shmatko1095/oshSchematic/BOM.ods

Sheet: Schematic
Source: | /media/user/SSD/projects/heatter/Schematic/Schematic.sch
Date: | чт, 14-жов-2021 22:14:58 +0300
Tool: | Eeschema 5.1.10-88a1d61d58~90~ubuntu20.04.1
Generator: | /usr/share/kicad/plugins/bom_csv_grouped_by_value_with_fp.py
Component Count: | 137
Ref | Qnty | Price x10 | Price |  |  | Value | Cmp name | Footprint | Description | Vendor
AE1, | 1 | 30 | 17.5 |  | FPC Antenna/GSM/2dbi/IPEX Connector | Antenna | Antenna | Connector_Wire:SolderWire-0.1sqmm_1x01_D0.4mm_OD1mm_Relief | Antenna
BT1, | 1 | 6.72 | 8 |  |  | CR2032-PBN2 | Battery_Cell | Battery:Battery_Panasonic_CR2032-VS1N_Vertical_CircularHoles | Single-cell battery
BZ1, | 1 | 36 | 50 |  |  | IE122305-7 | Buzzer | Buzzer_Beeper:Buzzer_12x9.5RM7.6 | Buzzer, polarized
C1, C8, C11, C12, C14, C16, C20, C23, | 8 | 0.2 |  | 40 |  | 0.1uF | C_Small | Capacitor_SMD:C_0805_2012Metric | Unpolarized capacitor, small symbol
C2, | 1 | 3.64 | 5 |  |  | 22uF | C_Small | Capacitor_SMD:C_1206_3216Metric | Unpolarized capacitor, small symbol
C3, C5, | 2 | 0.54 |  | 10 |  | 47pF | C_Small | Capacitor_SMD:C_0805_2012Metric | Unpolarized capacitor, small symbol
C4, C6, C10, | 3 | 0.61 |  | 10 |  | 10uF | C_Polarized | Capacitor_SMD:C_0805_2012Metric | Polarized capacitor
C7, C13, | 2 | 0.88 | 1.5 |  |  | 470uF | C_Polarized | Capacitor_THT:CP_Radial_D6.3mm_P2.50mm | Polarized capacitor
C15, | 1 | 4 | 5 |  |  | SMDCAP-470mkf - 10v | C_Polarized | Capacitor_SMD:CP_Elec_8x10 | Polarized capacitor
C17, C18, C19, C21, | 4 | 0.2 |  | 40 |  | 33pF | C_Small | Capacitor_SMD:C_0805_2012Metric | Unpolarized capacitor, small symbol
C24, C25, | 2 | 0 | 0 |  |  | NM | C_Small | Capacitor_SMD:C_0805_2012Metric | Unpolarized capacitor, small symbol
D1, D2, D3, D4, D5, D6, D7, D9, D10, | 7 | 0.1 | 1.5 |  |  | LED | LED | LED_SMD:LED_0805_2012Metric | Light emitting diode
D8, | 1 | 1 | 1.5 |  |  | BZV55B5V1 | BZV55B5V1 | Diode_SMD:D_MiniMELF | 5.1V, 500mW, 2%, Zener diode, MiniMELF
D11, D14, D15, D18, D20, D21, D22, D23, D24, D25, | 10 | 0.3 | 2.5 |  |  | ESD5Z3.3T1G | DZ2S030X0L | Diode_SMD:D_SOD-523 | 150mW Silicon Planar Zener Diode, 3.0V, SOD-523
D12, D16, D17, D19, | 4 | 2.6 | 7.5 |  |  | PESD5V0L4UG | PESD5V0L4UG | Package_TO_SOT_SMD:SOT-353_SC-70-5 | Low capacitance unidirectional quadruple ESD protection diode array, 5.0V, Common Anode, SOT-353
D13, | 1 | 2.6 | 7.5 |  |  | PESD3V3L4UG | PESD3V3L4UG | Package_TO_SOT_SMD:SOT-353_SC-70-5 | Low capacitance unidirectional quadruple ESD protection diode array, 3.3V, Common Anode, SOT-353
F1, | 1 | 0.6 | 1.5 |  | FUSE 0.5A 250V 3X10 | 3,6x10 0.5A | Fuse | Fuse:Fuse_BelFuse_0ZRE0033FF_L11.4mm_W3.8mm | Fuse
J1, | 1 | 1.6 | 2.5 |  | NCDW-02 | CS | Conn_01x02 | Connector_PinSocket_2.54mm:PinSocket_1x02_P2.54mm_Vertical | Generic connector, single row, 01x02, script generated (kicad-library-utils/schlib/autogen/connector/)
J2, | 1 | 0 | 0 |  | PLS-40-BLACK | CC2538_USB | Conn_01x03 | Connector_PinSocket_2.54mm:PinSocket_1x03_P2.54mm_Vertical | Generic connector, single row, 01x03, script generated (kicad-library-utils/schlib/autogen/connector/)
J3, | 1 | 0 | 0 |  | ZL202-20G | CC2538_JTAG | Conn_02x05_Odd_Even | Connector_PinHeader_2.54mm:PinHeader_2x05_P2.54mm_Vertical | Generic connector, double row, 02x05, odd/even pin numbering scheme (row 1 odd numbers, row 2 even numbers), script generated (kicad-library-utils/schlib/autogen/connector/)
J4, J5, J6, J7, | 4 | 2.4 | 3.5 |  | NCDW-03 | DS18B20 | Conn_01x03 | Connector_PinSocket_2.54mm:PinSocket_1x03_P2.54mm_Vertical | Generic connector, single row, 01x03, script generated (kicad-library-utils/schlib/autogen/connector/)
J8, | 1 | 3 | 4.5 |  | BH-08 | Heater Board | Conn_02x04_Odd_Even | Connector_PinSocket_2.54mm:PinSocket_2x04_P2.54mm_Vertical | Generic connector, double row, 02x04, odd/even pin numbering scheme (row 1 odd numbers, row 2 even numbers), script generated (kicad-library-utils/schlib/autogen/connector/)
J9, | 1 | 2.4 | 3.5 |  | NCDW-03 | TCBBA00 | Conn_01x03 | Connector_PinSocket_2.54mm:PinSocket_1x03_P2.54mm_Vertical | Generic connector, single row, 01x03, script generated (kicad-library-utils/schlib/autogen/connector/)
J10, | 1 | 13.62 | 19 |  | NANOSIM-HINGE-1.5H | SIM_Card | SIM_Card | Connector_Card:NANOSIM_HINGE_1.5H | SIM Card
J11, | 1 | 1 | 2 |  |  | ESP_UART | Conn_02x03_Odd_Even | Connector_PinHeader_2.54mm:PinHeader_2x03_P2.54mm_Vertical | Generic connector, double row, 02x03, odd/even pin numbering scheme (row 1 odd numbers, row 2 even numbers), script generated (kicad-library-utils/schlib/autogen/connector/)
J12, | 1 | 1 | 9 |  | ZL202-20G | ESP_JTAG | Conn_02x05_Odd_Even | Connector_PinHeader_2.54mm:PinHeader_2x05_P2.54mm_Vertical | Generic connector, double row, 02x05, odd/even pin numbering scheme (row 1 odd numbers, row 2 even numbers), script generated (kicad-library-utils/schlib/autogen/connector/)
J13, | 1 | 2.5 | 3 |  | DG126-5.0-02P-14-00AH | 220V | Conn_01x02 | Connector_Phoenix_MSTB:PhoenixContact_MSTBA_2,5_2-G_1x02_P5.00mm_Horizontal | Generic connector, single row, 01x02, script generated (kicad-library-utils/schlib/autogen/connector/)
J16, | 1 | 11.34 | 13.5 |  | DS1065-03-2X6S8BV ZL322-2X6P | Conn_TFT | Conn_02x06_Odd_Even | Connector_PinHeader_1.27mm:PinHeader_2x06_P1.27mm_Vertical | Generic connector, double row, 02x06, odd/even pin numbering scheme (row 1 odd numbers, row 2 even numbers), script generated (kicad-library-utils/schlib/autogen/connector/)
PS1, | 1 | 258 | 258 |  |  | IRM-20-5 | IRM-20-5 | Converter_ACDC:Converter_ACDC_MeanWell_IRM-20-xx_THT | 5V, 4A, 20W, Isolated, AC-DC, 219A(IRM20)
Q1, Q3, Q4, Q5, | 4 | 0.3 |  | 10 |  | BC847 | BC847 | Package_TO_SOT_SMD:SOT-23 | 0.1A Ic, 45V Vce, NPN Transistor, SOT-23
R1, R2, R4, R5, R10, R11, R15, R16, R21, R23, R24, R25, R26, R27, | 14 | 0.06 |  | 12 |  | 10k | R | Resistor_SMD:R_0805_2012Metric | Resistor
R3, | 1 | 0.09 |  | 17 |  | 100 1/8W | R | Resistor_SMD:R_1206_3216Metric | Resistor
R6, R7, R8, R9, R17, R18, R19, R20, R36, R51, R52, R53, R54, R55, R56, | 15 | 0.06 |  | 12 |  | 1k | R | Resistor_SMD:R_0805_2012Metric | Resistor
R12, R13, | 2 | 0.38 |  | 10 |  | 33 | R | Resistor_SMD:R_0805_2012Metric | Resistor
R14, | 1 | 0.06 |  | 12 |  | 1k5 | R | Resistor_SMD:R_0805_2012Metric | Resistor
R22, R39, R40, R43, | 4 | 0.06 |  | 12 |  | 47k | R | Resistor_SMD:R_0805_2012Metric | Resistor
R33, | 1 | 0.06 |  | 12 |  | 124k | R | Resistor_SMD:R_0805_2012Metric | Resistor
R34, | 1 | 0.06 |  | 12 |  | 56k | R | Resistor_SMD:R_0805_2012Metric | Resistor
R37, R38, R42, | 3 | 0.06 |  | 12 |  | 4k7 | R | Resistor_SMD:R_0805_2012Metric | Resistor
R41, R44, | 2 | 0.06 |  | 12 |  | 300R | R | Resistor_SMD:R_0805_2012Metric | Resistor
R45, R46, R47, | 3 | 0.06 |  | 12 |  | 22R | R | Resistor_SMD:R_0805_2012Metric | Resistor
R48, R49, R50, | 3 | 0.06 |  | 12 |  | 5k6 | R | Resistor_SMD:R_0805_2012Metric | Resistor
R57, | 1 | 0.06 |  | 12 |  | 0R | R | Resistor_SMD:R_0805_2012Metric | Resistor
RV1, | 1 | 2.7 | 3 |  |  | 10D561K | Varistor | Varistor:RV_Disc_D12mm_W3.9mm_P7.5mm | Voltage dependent resistor
U1, | 1 | 62.1 |  |  |  | ESP32-S2-WROVER-I | ESP32-S2-WROVER-I | RF_Module:ESP32-S2-WROVER | RF Module, ESP32-D0WDQ6 SoC, Wi-Fi 802.11b/g/n, 32-bit, 2.7-3.6V, onboard antenna, SMD
U2, | 1 | 160 | 251 |  |  | CC2538_CC2592 | CC2538_CC2592 | RF_Module:CC2538_CC2592 | Chinese CC2538_CC2592 zigbee module SZ12 V2 BTTCOM
U3, | 1 | 27 | 111.5 |  |  | DS3231M | DS3231M | Package_SO:SOIC-16W_7.5x10.3mm_P1.27mm | Extremely Accurate I2C-Integrated RTC/TCXO/Crystal SOIC-16
U5, | 1 | 12 | 43 |  |  | LD1086DT33TR | LD1086DT33TR | Package_TO_SOT_SMD:TO-252-2 | Positive, 1.5A 30V, Linear Regulator, Fixed Output 3.3V, TO-252
U6, | 1 | 15 | 106 |  |  | MIC29302AWU | MIC29302WU | Package_TO_SOT_SMD:TO-263-5_TabPin3 | 3A low dropout linear regulator, adjustable output, TO-263
U7, | 1 |  |  |  |  | M66 | M66 | RF_GSM:Quectel_M66
 |  | 667.08 | 1211

Sheet: Sheet2
Source: | /media/user/SSD/projects/heatter/Schematic/LCD_board/LCD_board.sch
Date: | чт, 14-жов-2021 22:16:45 +0300
Tool: | Eeschema 5.1.10-88a1d61d58~90~ubuntu20.04.1
Generator: | /usr/share/kicad/plugins/bom_csv_grouped_by_value_with_fp.py
Component Count: | 10
Ref | Qnty | Value | Cmp name | Footprint | Description | Vendor
C1, | 1 | 10uF | C | Capacitor_SMD:C_1210_3225Metric | Unpolarized capacitor
C2, | 1 | 0.1uF | C | Capacitor_SMD:C_0805_2012Metric | Unpolarized capacitor
J1, | 1 | Conn_02x06 | Conn_02x06_Odd_Even | Connector_PinHeader_1.27mm:PinHeader_2x06_P1.27mm_Vertical_SMD | Generic connector, double row, 02x06, odd/even pin numbering scheme (row 1 odd numbers, row 2 even numbers), script generated (kicad-library-utils/schlib/autogen/connector/)
Q1, | 1 | BC847 | BC847 | Package_TO_SOT_SMD:SOT-23 | 0.1A Ic, 45V Vce, NPN Transistor, SOT-23
R1, | 1 | 1k | R | Resistor_SMD:R_0805_2012Metric | Resistor
R2, | 1 | 47k | R | Resistor_SMD:R_0805_2012Metric | Resistor
R3, R4, | 2 | 10k | R | Resistor_SMD:R_0805_2012Metric | Resistor
R5, | 1 | 300R | R | Resistor_SMD:R_0805_2012Metric | Resistor
U1, | 1 | TT130RGC17B | TT130RGC17B | Connector_FFC-FPC:TE_1-1734839-8_1x18-1MP_P0.5mm_Horizontal | TT130RGC17B is a color round active matrix and touch screen with capacitance thin film transistor(TFT)liquid crystal display(LCD)that uses amorphous silicon TFT as a switching device. This TFT LCD has a 1.3inch diagonally measured active display area with (240 horizontal by 240 vertical pixels)resolution.
