shmatko1095/oshSchematic/Schematic.kicad_pcb

## KiCad design Schematic.kicad_pcb (2021-10-18)

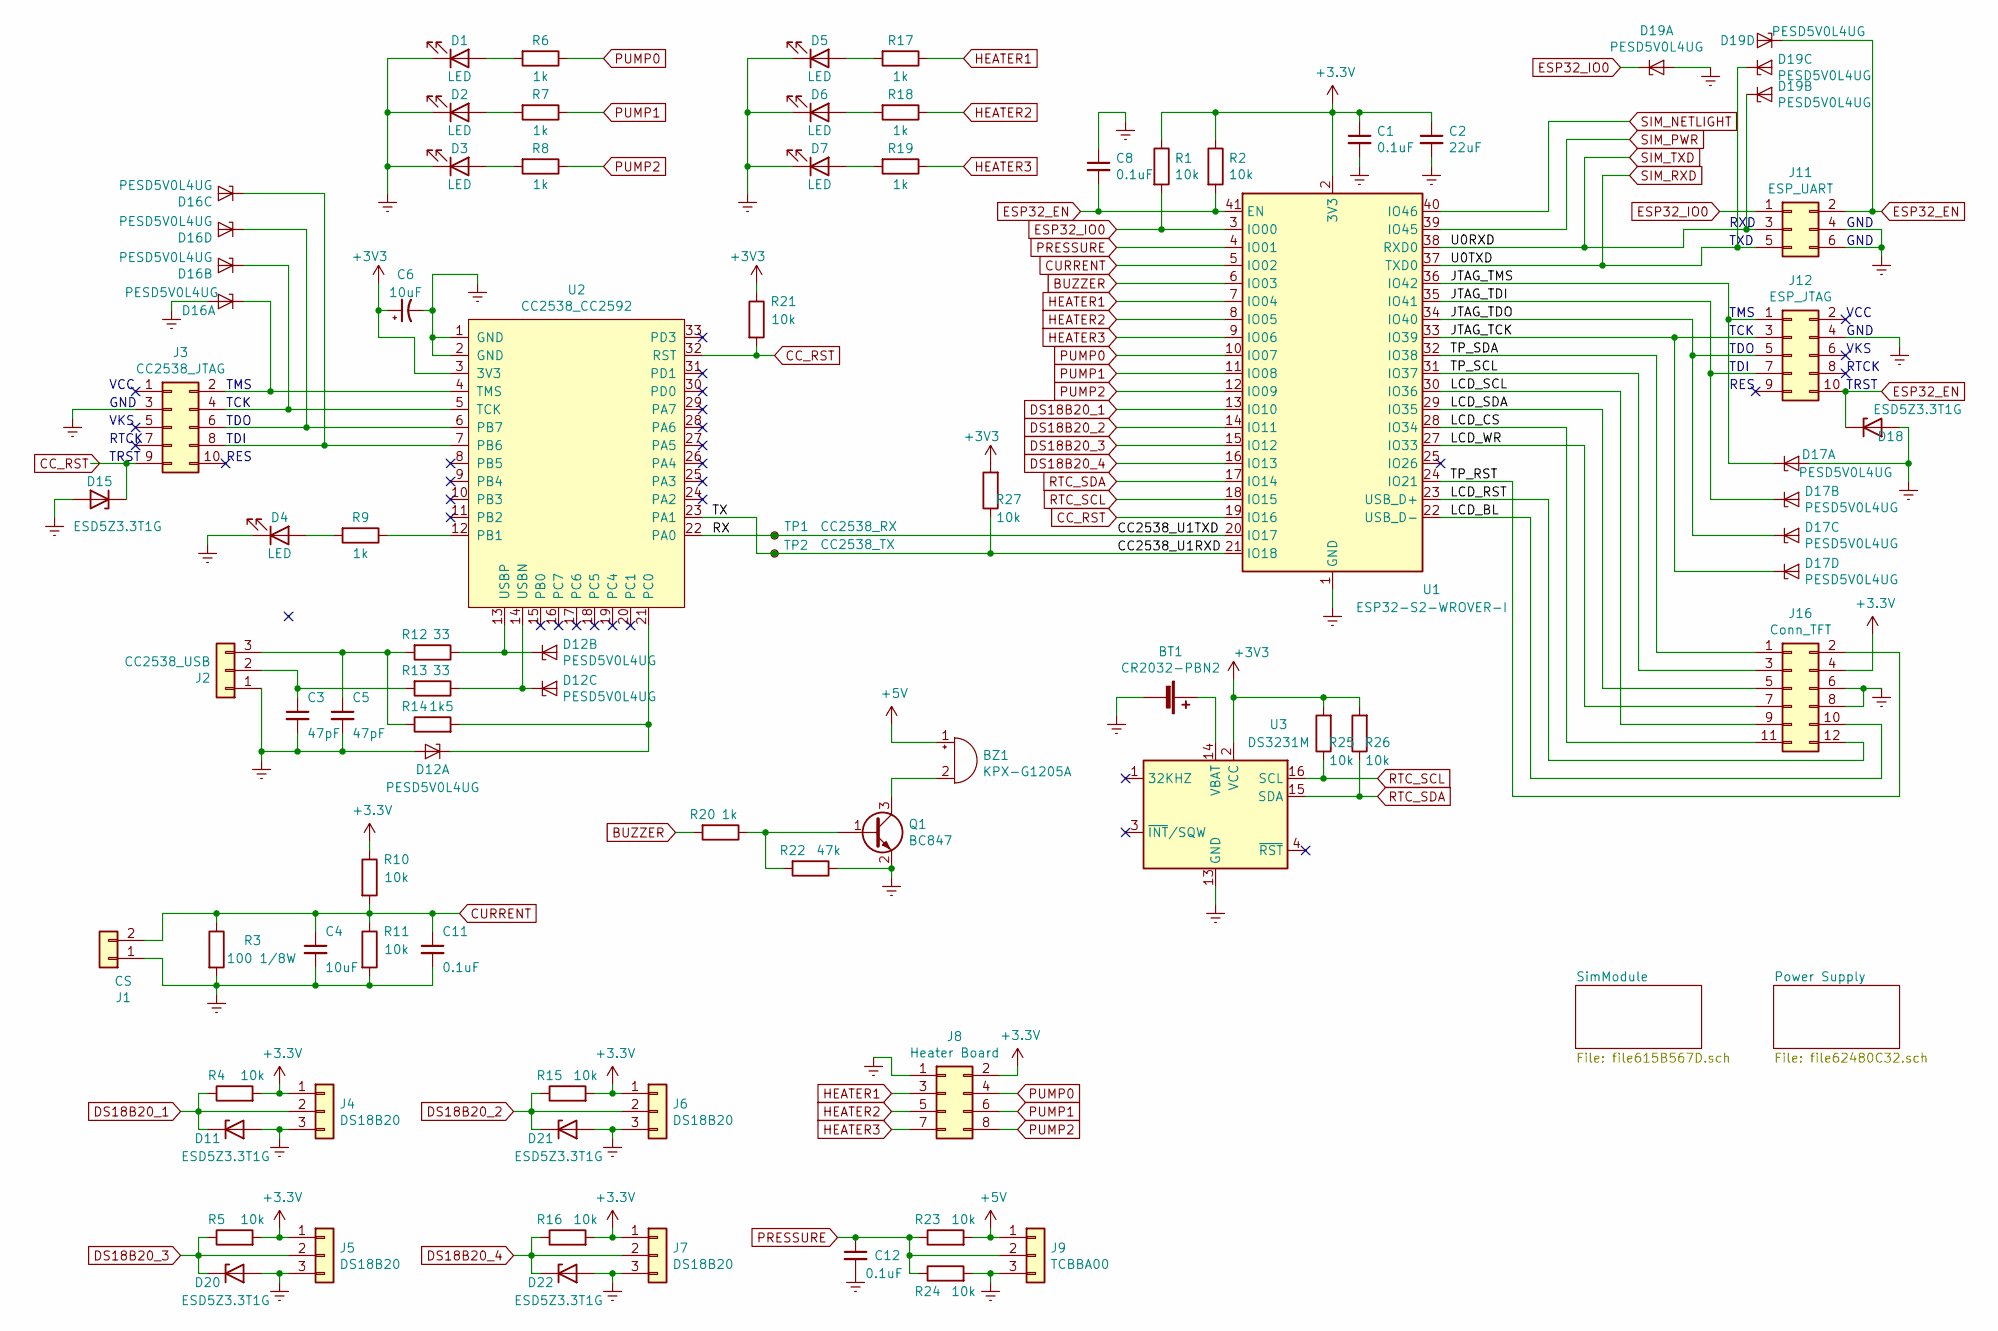
[picture p1: schematic Schematic.sch]

Parts:
BT1: CR2032-PBN2; Battery_Panasonic_CR2032-VS1N_Vertical_CircularHoles
BZ1: KPX-G1205A; Buzzer_12x9.5RM7.6
C1, C8, C11, C12: 0.1uF; C_0805_2012Metric
C2: 22uF; C_1206_3216Metric
C3, C5: 47pF; C_0805_2012Metric
C4, C6: 10uF; C_0805_2012Metric
D1, D2, D3, D4, D5, D6, D7: LED; LED_0805_2012Metric
D11, D15, D18, D20, D21, D22: ESD5Z3.3T1G; D_SOD-523
D12, D16, D17, D19: PESD5V0L4UG; SOT-353_SC-70-5
J1: CS; PinSocket_1x02_P2.54mm_Vertical
J2: CC2538_USB; PinSocket_1x03_P2.54mm_Vertical
J3: CC2538_JTAG; PinHeader_2x05_P2.54mm_Vertical
J4, J5, J6, J7: DS18B20; PinSocket_1x03_P2.54mm_Vertical
J8: Heater Board; PinSocket_2x04_P2.54mm_Vertical
J9: TCBBA00; PinSocket_1x03_P2.54mm_Vertical
J11: ESP_UART; PinHeader_2x03_P2.54mm_Vertical
J12: ESP_JTAG; PinHeader_2x05_P2.54mm_Vertical
J16: Conn_TFT; PinHeader_2x06_P1.27mm_Vertical
Q1: BC847; SOT-23
R1, R2, R4, R5, R10, R11, R15, R16, R21, R23, R24, R25, R26, R27: 10k; R_0805_2012Metric
R3: 100 1/8W; R_1206_3216Metric
R6, R7, R8, R9, R17, R18, R19, R20: 1k; R_0805_2012Metric
R12, R13: 33; R_0805_2012Metric
R14: 1k5; R_0805_2012Metric
R22: 47k; R_0805_2012Metric
TP1: CC2538_RX; TestPoint_Pad_D1.5mm
TP2: CC2538_TX; TestPoint_Pad_D1.5mm
U1: ESP32-S2-WROVER-I; ESP32-S2-WROVER
U2: CC2538_CC2592
U3: DS3231M; SOIC-16W_7.5x10.3mm_P1.27mm

Connections:
+5V: BZ1.1 (-), J9.1, R23.2; also elsewhere on the board
/CC2538_U1RXD: R27.1, TP2.1, U1.21 (IO18), U2.23 (PA1)
/CC2538_U1TXD: TP1.1, U1.20 (IO17), U2.22 (PA0)
/JTAG_TCK: D17.5 (K4), J12.3, U1.33 (IO39)
/JTAG_TDI: D17.3 (K2), J12.7, U1.35 (IO41)
/JTAG_TDO: D17.4 (K3), J12.5, U1.34 (IO40)
/JTAG_TMS: D17.1 (K1), J12.1, U1.36 (IO42)
/LCD_BL: J16.10, U1.22 (USB_D-)
/LCD_CS: J16.11, U1.28 (IO34)
/LCD_RST: J16.12, U1.23 (USB_D+)
/LCD_SCL: J16.9, U1.30 (IO36)
/LCD_SDA: J16.5, U1.29 (IO35)
/LCD_WR: J16.7, U1.27 (IO33)
/TP_RST: J16.2, U1.24 (IO21)
/TP_SCL: J16.3, U1.31 (IO37)
/TP_SDA: J16.1, U1.32 (IO38)
BUZZER: R20.2, U1.6 (IO03)
CC_RST: D15.1 (K), J3.9, R21.2, U1.19 (IO16), U2.32 (RST)
CURRENT: C4.1, C11.1, J1.2, R3.1, R10.2, R11.1, U1.5 (IO02)
DS18B20_1: D11.1 (K), J4.2, R4.1, U1.13 (IO10)
DS18B20_2: D21.1 (K), J6.2, R15.1, U1.14 (IO11)
DS18B20_3: D20.1 (K), J5.2, R5.1, U1.15 (IO12)
DS18B20_4: D22.1 (K), J7.2, R16.1, U1.16 (IO13)
ESP32_EN: C8.2, D18.1 (K), D19.5 (K4), J11.2, J12.10, R2.2, U1.41 (EN)
ESP32_IO0: D19.1 (K1), J11.1, R1.2, U1.3 (IO00)
Earth: BT1.2 (-), C1.2, C2.2, C3.2, C4.2, C5.2, C6.2, C8.1, C11.2, C12.2, D1.1 (K), D2.1 (K), D3.1 (K), D4.1 (K), D5.1 (K), D6.1 (K), D7.1 (K), D11.2 (A), D12.2 (A), D15.2 (A), D16.2 (A), D17.2 (A), D18.2 (A), D19.2 (A), D20.2 (A), D21.2 (A), D22.2 (A), J1.1, J2.1, J3.3, J4.3, J5.3, J6.3, J7.3, J8.1, J9.3, J11.4, J11.6, J12.4, J16.6, J16.8, Q1.2 (E), R3.2, R11.2, R22.1, R24.2, U1.1 (GND), U1.26 (GND), U1.42 (GND), U1.43 (GND), U2.1 (GND), U2.2 (GND), U3.5 (GND), U3.6 (GND), U3.7 (GND), U3.8 (GND), U3.9 (GND), U3.10 (GND), U3.11 (GND), U3.12 (GND), U3.13 (GND); also elsewhere on the board
HEATER1: J8.3, R17.1, U1.7 (IO04)
HEATER2: J8.5, R18.1, U1.8 (IO05)
HEATER3: J8.7, R19.1, U1.9 (IO06)
unnamed: BT1.1 (+), U3.14 (VBAT)
unnamed: BZ1.2 (+), Q1.3 (C)
unnamed: C3.1, J2.2, R13.2
unnamed: C5.1, J2.3, R12.2, R14.1
unnamed: D1.2 (A), R6.2
unnamed: D2.2 (A), R7.2
unnamed: D3.2 (A), R8.2
unnamed: D4.2 (A), R9.2
unnamed: D5.2 (A), R17.2
unnamed: D6.2 (A), R18.2
unnamed: D7.2 (A), R19.2
unnamed: D12.1 (K1), R14.2, U2.21 (PC0)
unnamed: D12.3 (K2), R12.1, U2.13 (USBP)
unnamed: D12.4 (K3), R13.1, U2.14 (USBN)
unnamed: D16.1 (K1), J3.2, U2.4 (TMS)
unnamed: D16.3 (K2), J3.4, U2.5 (TCK)
unnamed: D16.4 (K3), J3.8, U2.7 (PB6)
unnamed: D16.5 (K4), J3.6, U2.6 (PB7)
unnamed: Q1.1 (B), R20.1, R22.2
unnamed: R9.1, U2.12 (PB1)
PRESSURE: C12.1, J9.2, R23.1, R24.1, U1.4 (IO01)
PUMP0: J8.4, R6.1, U1.10 (IO07)
PUMP1: J8.6, R7.1, U1.11 (IO08)
PUMP2: J8.8, R8.1, U1.12 (IO09)
RTC_SCL: R25.1, U1.18 (IO15), U3.16 (SCL)
RTC_SDA: R26.1, U1.17 (IO14), U3.15 (SDA)
SIM_NETLIGHT: U1.40 (IO46); also elsewhere on the board
SIM_PWR: U1.39 (IO45); also elsewhere on the board
SIM_RXD: D19.4 (K3), J11.5, U1.37 (TXD0); also elsewhere on the board
SIM_TXD: D19.3 (K2), J11.3, U1.38 (RXD0); also elsewhere on the board

Notes on the sheet:
VCC
TRST
RTCK
GND
VKS
TMS
TCK
TDO
TDI
RES
RXD
TXD

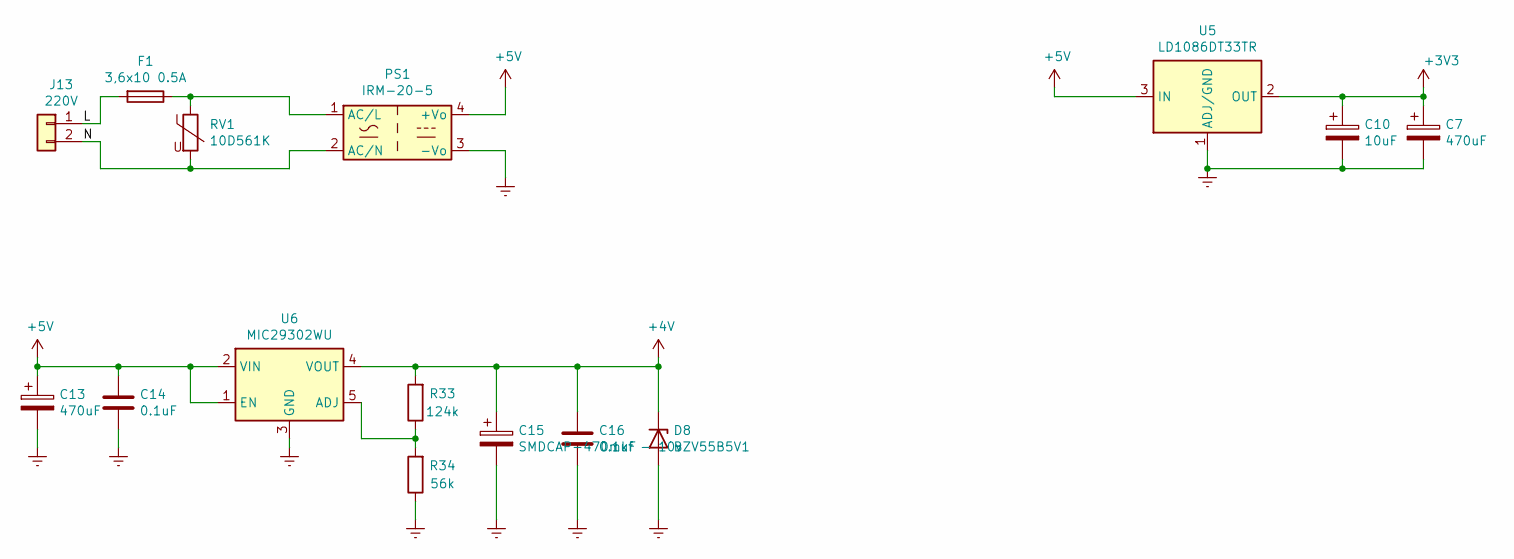
[picture p2: schematic file62480C32.sch]

Parts:
C7, C13: 470uF; CP_Radial_D6.3mm_P2.50mm
C10: 10uF; C_0805_2012Metric
C14, C16: 0.1uF; C_0805_2012Metric
C15: SMDCAP-470mkf - 10v; CP_Elec_8x10
D8: BZV55B5V1; D_MiniMELF
F1: 3,6x10 0.5A; Fuse_BelFuse_0ZRE0033FF_L11.4mm_W3.8mm
J13: 220V; PhoenixContact_MSTBA_2,5_2-G_1x02_P5.00mm_Horizontal
PS1: IRM-20-5; Converter_ACDC_MeanWell_IRM-20-xx_THT
R33: 124k; R_0805_2012Metric
R34: 56k; R_0805_2012Metric
RV1: 10D561K; RV_Disc_D12mm_W3.9mm_P7.5mm
U5: LD1086DT33TR; TO-252-2
U6: MIC29302WU; TO-263-5_TabPin3

Connections:
+4V: C15.1, C16.1, D8.1 (K), R33.2, U6.4 (VOUT); also elsewhere on the board
+5V: C13.1, C14.1, PS1.4 (+Vo), U5.3 (IN), U6.1 (EN), U6.2 (VIN); also elsewhere on the board
/Power Supply/L: F1.2, J13.1
/Power Supply/N: J13.2, PS1.2 (AC/N), RV1.2
Earth: C7.2, C10.2, C13.2, C14.2, C15.2, C16.2, D8.2 (A), PS1.3 (-Vo), R34.1, U5.1 (ADJ/GND), U6.3 (GND); also elsewhere on the board
unnamed: F1.1, PS1.1 (AC/L), RV1.1
unnamed: R33.1, R34.2, U6.5 (ADJ)

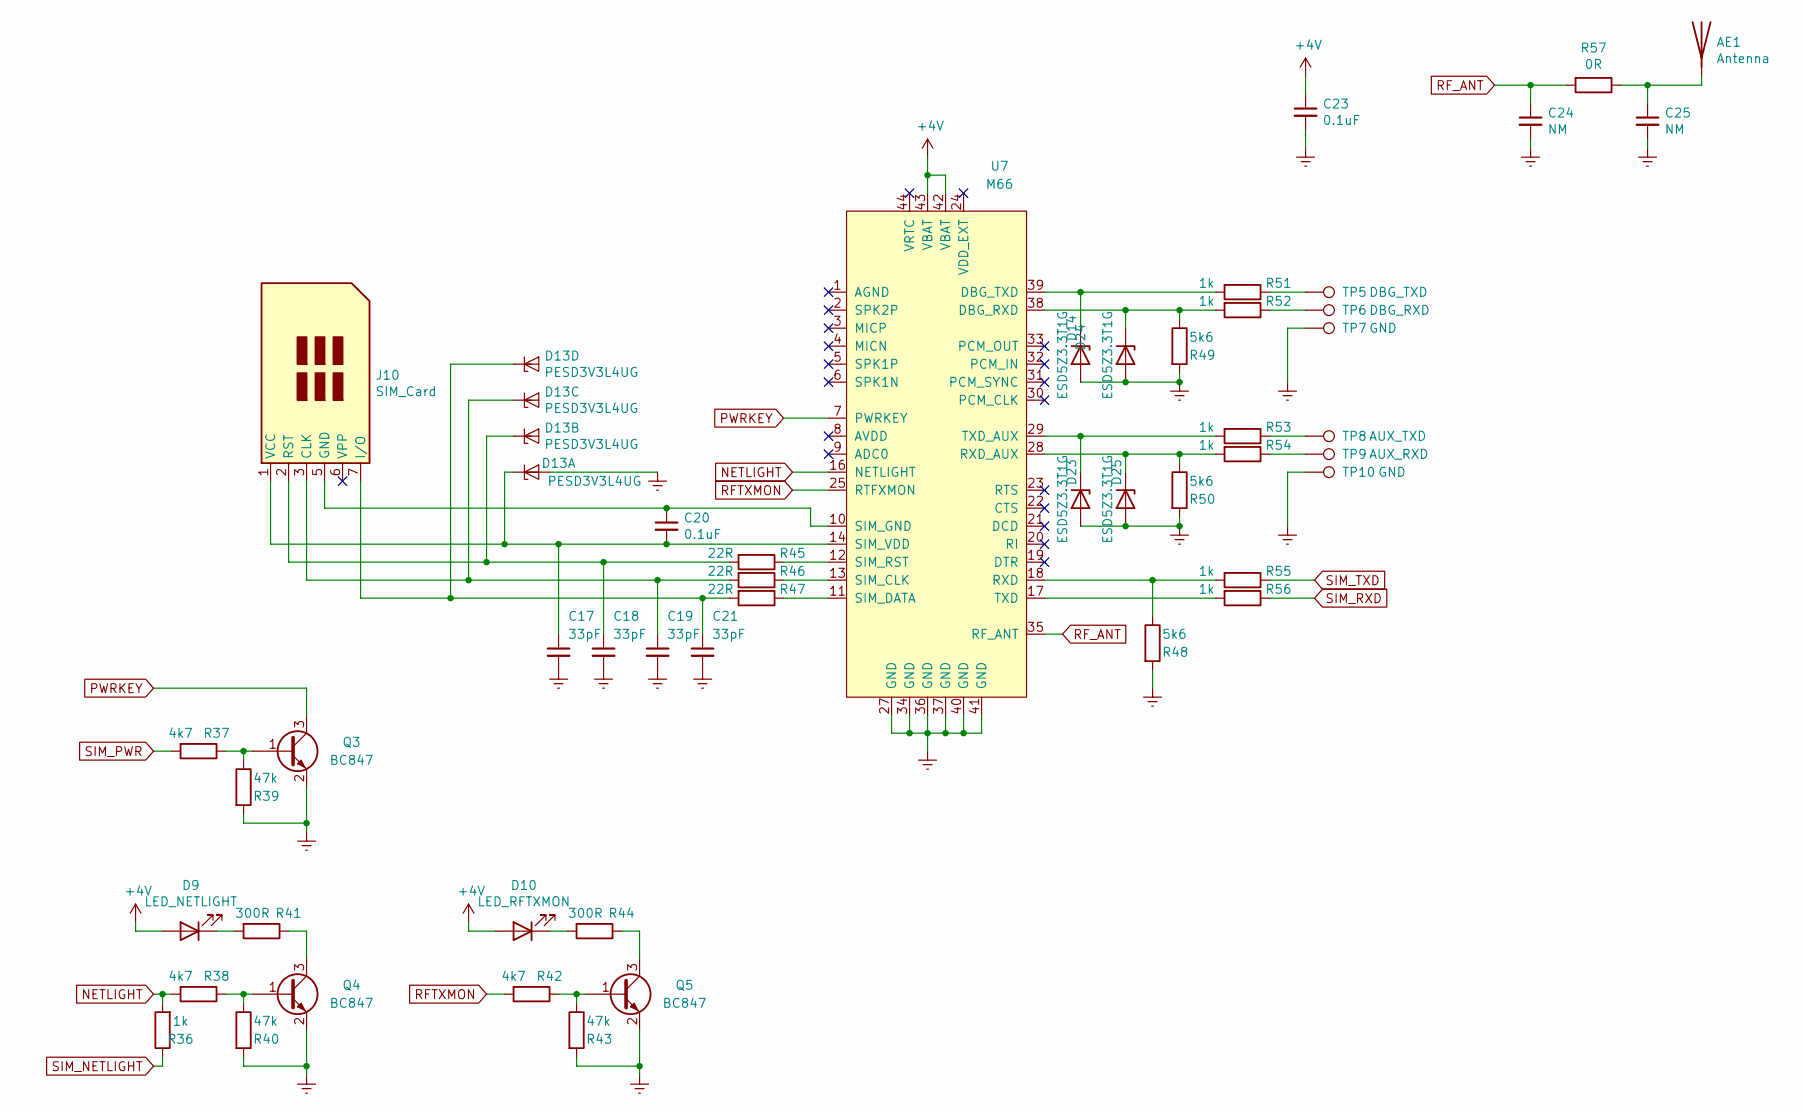
[picture p3: schematic file615B567D.sch]

Parts:
AE1: Antenna; SolderWire-0.1sqmm_1x01_D0.4mm_OD1mm_Relief
C17, C18, C19, C21: 33pF; C_0805_2012Metric
C20, C23: 0.1uF; C_0805_2012Metric
C24, C25: NM; C_0805_2012Metric
D9: LED_NETLIGHT; LED_0805_2012Metric
D10: LED_RFTXMON; LED_0805_2012Metric
D13: PESD3V3L4UG; SOT-353_SC-70-5
D14, D23, D24, D25: ESD5Z3.3T1G; D_SOD-523
J10: SIM_Card; NANOSIM_HINGE_1.5H
Q3, Q4, Q5: BC847; SOT-23
R36, R51, R52, R53, R54, R55, R56: 1k; R_0805_2012Metric
R37, R38, R42: 4k7; R_0805_2012Metric
R39, R40, R43: 47k; R_0805_2012Metric
R41, R44: 300R; R_0805_2012Metric
R45, R46, R47: 22R; R_0805_2012Metric
R48, R49, R50: 5k6; R_0805_2012Metric
R57: 0R; R_0805_2012Metric
TP5: DBG_TXD; TestPoint_Pad_1.0x1.0mm
TP6: DBG_RXD; TestPoint_Pad_1.0x1.0mm
TP7, TP10: GND; TestPoint_Pad_1.0x1.0mm
TP8: AUX_TXD; TestPoint_Pad_1.0x1.0mm
TP9: AUX_RXD; TestPoint_Pad_1.0x1.0mm
U7: M66; Quectel_M66

Connections:
+4V: C23.1, D9.2 (A), D10.2 (A), U7.42 (VBAT), U7.43 (VBAT); also elsewhere on the board
Earth: C17.2, C18.2, C19.2, C21.2, C23.2, C24.2, C25.2, D13.2 (A), D14.2 (A), D23.2 (A), D24.2 (A), D25.2 (A), Q3.2 (E), Q4.2 (E), Q5.2 (E), R39.2, R40.2, R43.2, R48.2, R49.2, R50.2, TP7.1, TP10.1, U7.27 (GND), U7.34 (GND), U7.36 (GND), U7.37 (GND), U7.40 (GND), U7.41 (GND); also elsewhere on the board
NETLIGHT: R36.2, R38.2, U7.16 (NETLIGHT)
unnamed: AE1.1, C25.1, R57.1
unnamed: C17.1, C20.2, D13.1 (K1), J10.1 (VCC), U7.14 (SIM_VDD)
unnamed: C18.1, D13.3 (K2), J10.2 (RST), R45.2
unnamed: C19.1, D13.4 (K3), J10.3 (CLK), R46.2
unnamed: C20.1, J10.5 (GND), U7.10 (SIM_GND)
unnamed: C21.1, D13.5 (K4), J10.7 (I/O), R47.2
unnamed: D9.1 (K), R41.2
unnamed: D10.1 (K), R44.2
unnamed: D14.1 (K), R51.2, U7.39 (DBG_TXD)
unnamed: D23.1 (K), R53.2, U7.29 (TXD_AUX)
unnamed: D24.1 (K), R49.1, R52.2, U7.38 (DBG_RXD)
unnamed: D25.1 (K), R50.1, R54.2, U7.28 (RXD_AUX)
unnamed: Q3.1 (B), R37.1, R39.1
unnamed: Q4.1 (B), R38.1, R40.1
unnamed: Q4.3 (C), R41.1
unnamed: Q5.1 (B), R42.1, R43.1
unnamed: Q5.3 (C), R44.1
unnamed: R45.1, U7.12 (SIM_RST)
unnamed: R46.1, U7.13 (SIM_CLK)
unnamed: R47.1, U7.11 (SIM_DATA)
unnamed: R48.1, R55.2, U7.18 (RXD)
unnamed: R51.1, TP5.1
unnamed: R52.1, TP6.1
unnamed: R53.1, TP8.1
unnamed: R54.1, TP9.1
unnamed: R56.2, U7.17 (TXD)
PWRKEY: Q3.3 (C), U7.7 (PWRKEY)
RFTXMON: R42.2, U7.25 (RTFXMON)
RF_ANT: C24.1, R57.2, U7.35 (RF_ANT)
SIM_NETLIGHT: R36.1; also elsewhere on the board
SIM_PWR: R37.2; also elsewhere on the board
SIM_RXD: R56.1; also elsewhere on the board
SIM_TXD: R55.1; also elsewhere on the board

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
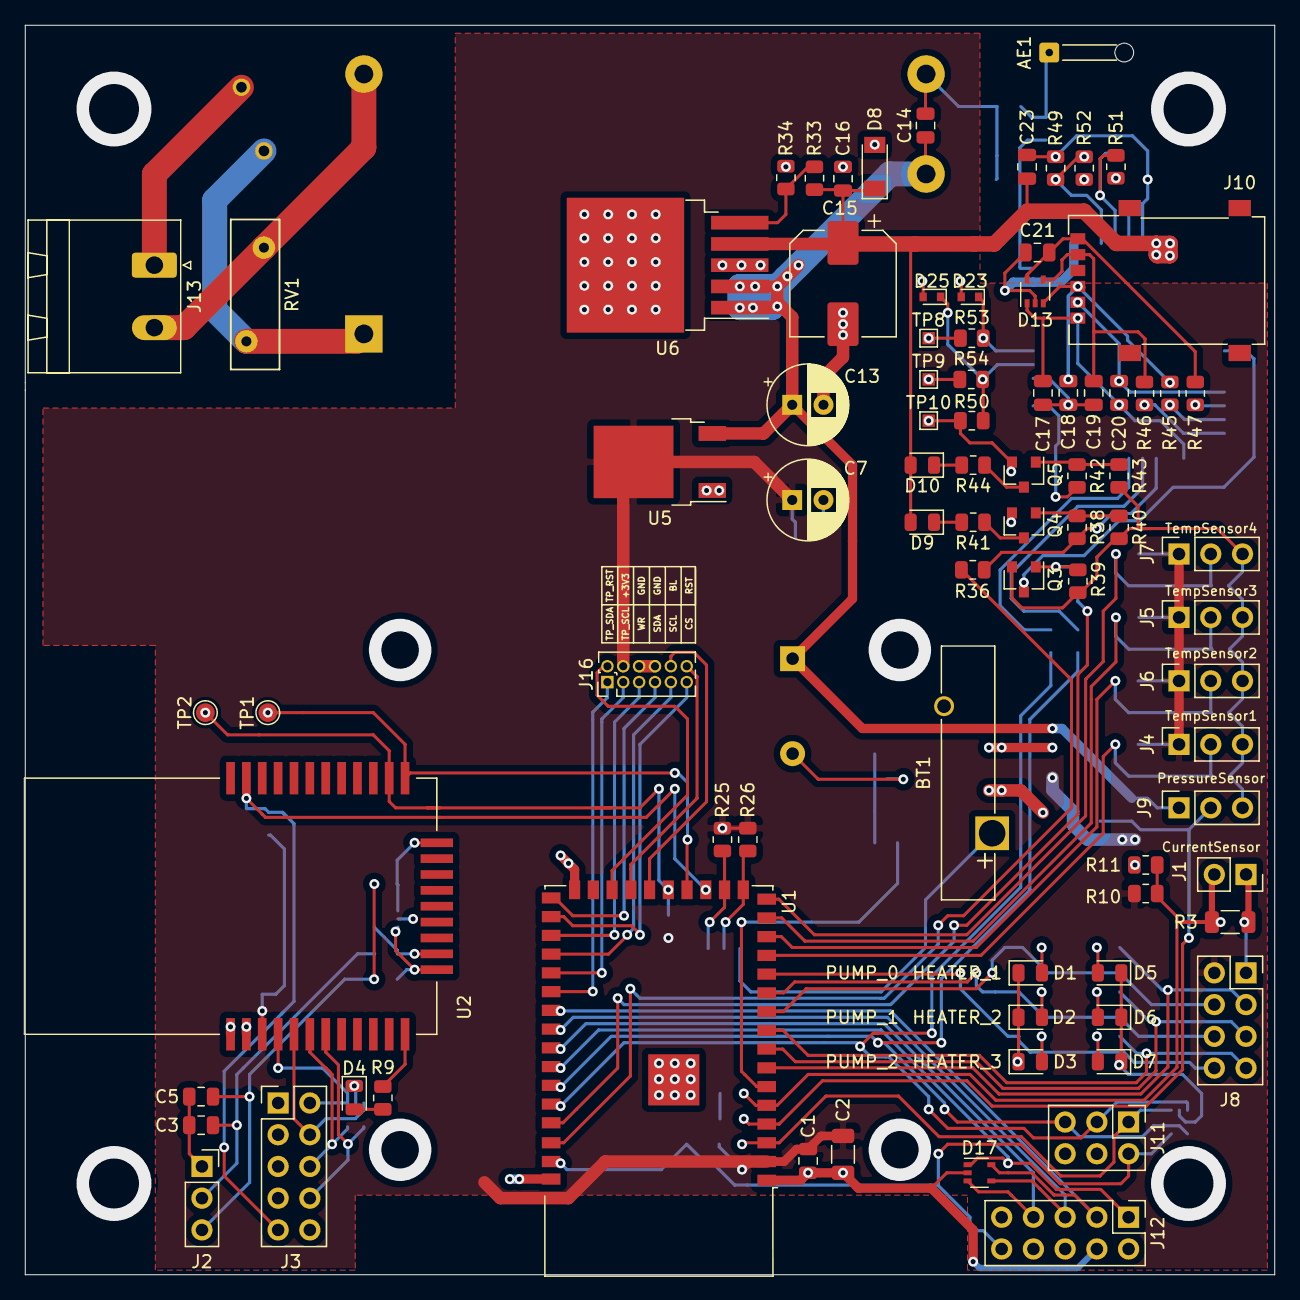
[picture p4: board Schematic.kicad_pcb from above]

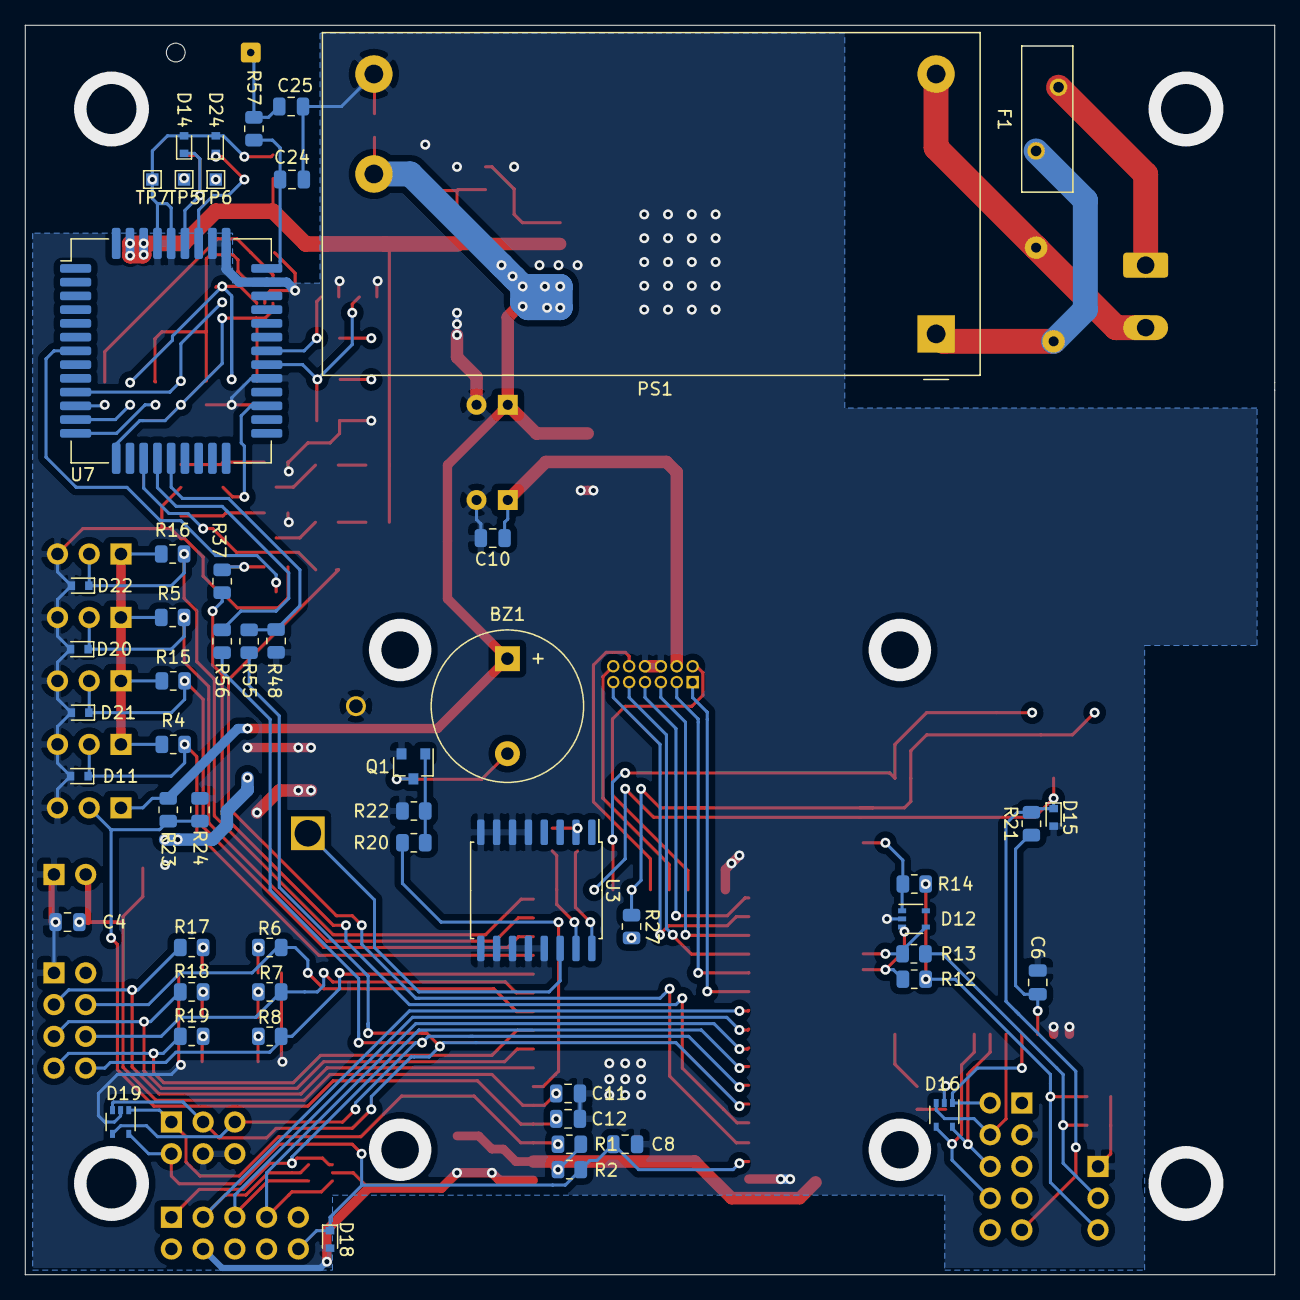
[picture p5: board Schematic.kicad_pcb from below]

Board: 2 copper layers, 100.0 x 100.0 mm, 137 parts (54 on the bottom side), 95 nets.
