shmatko1095/oshSchematic/LCD_board/LCD_board.kicad_pcb

## KiCad design LCD_board/LCD_board.kicad_pcb (2021-10-18)

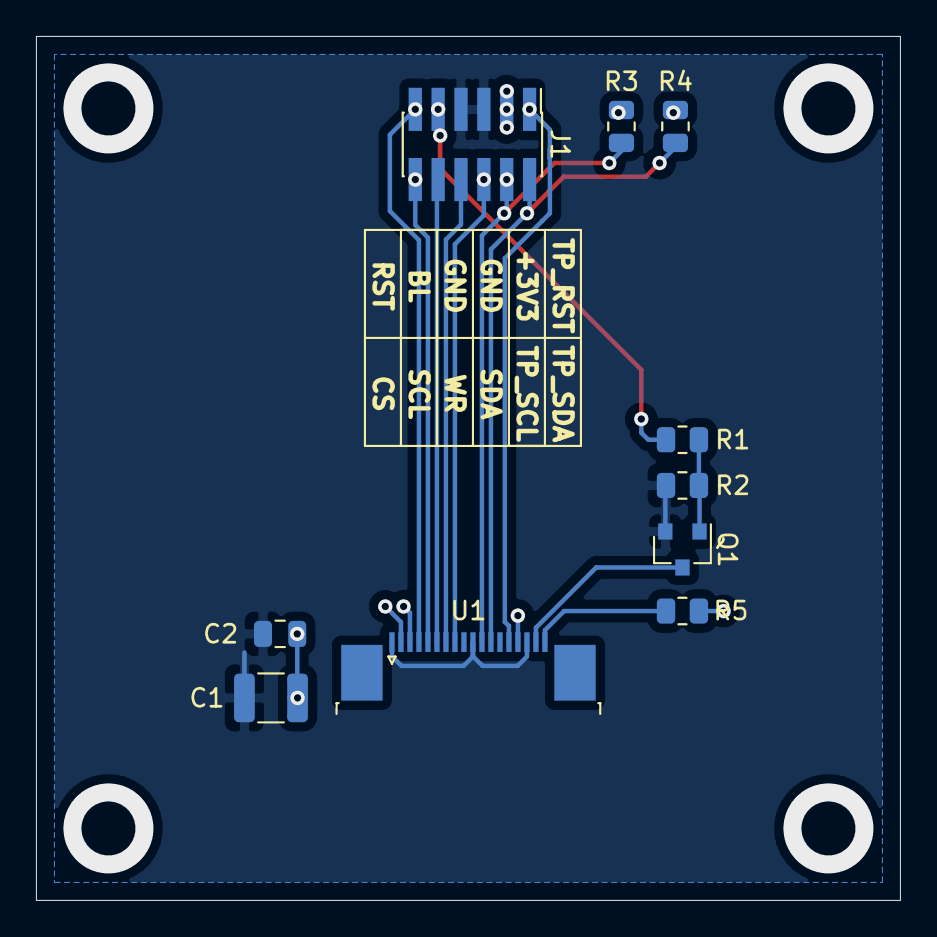
[picture p6: board LCD_board.kicad_pcb from below]

Board: 2 copper layers, 48.0 x 48.0 mm, 10 parts (10 on the bottom side), 14 nets.

Parts:
C1: C; C_1210_3225Metric
C2: C; C_0805_2012Metric
J1: Conn_02x06; PinHeader_2x06_P1.27mm_Vertical_SMD
Q1: BC847; SOT-23
R1, R2, R3, R4, R5: R; R_0805_2012Metric
U1: TT130RGC17B; TE_1-1734839-8_1x18-1MP_P0.5mm_Horizontal

Connections:
+3V3: C1.1, C2.1, J1.3, R3.2, R4.2, R5.2, U1.2, U1.3, U1.15
Earth: C1.2, C2.2, J1.5, J1.7, Q1.2, R2.1, U1.1, U1.10, U1.16
unnamed: J1.1, U1.14
unnamed: J1.2, R4.1, U1.12
unnamed: J1.4, R3.1, U1.11
unnamed: J1.6, U1.8
unnamed: J1.8, U1.7
unnamed: J1.9, R1.1
unnamed: J1.10, U1.6
unnamed: J1.11, U1.4
unnamed: J1.12, U1.5
unnamed: Q1.1, R1.2, R2.2
unnamed: Q1.3, U1.17
unnamed: R5.1, U1.18
